Connaxio/espoir/README.md

espoir_iso1_1080

# Espoir
Espoir is a Power over Ethernet+ (PoE+ (802.3af/at)), mikroBUS<sup>TM</sup> mainboard based on the ESP32-MINI-1.

The full documentation for the project can be found on [Connaxio's Wiki](https://connaxio.github.io/espoir/hardware.html), including features and specifications and quick-start guides for tools like Arduino and MicroPython.
