Connaxio/espoir/doc/design_calcs.ods

Sheet: MP6004
 |  |  | MP6004 method
Vin_max | 57 | V | I_pk_max | 2.673E+00 | A |  | Dmax | 45.70%
Vin_min | 37 | V | Vout_1 | 5.03E+00 | V |  | Isec rms max | 5.99E+00
Vd_max | 0.81 | V | Ilim | 2.641E+00 | A | Note : unused
Vd_min | 0.15 | V | Vcc | 11.53E+00 | V
V_LX max | 150 | V | Ton | 3.43E-06 | s
Rdson | 0.8 | Ohms | Tcon | 4.07E-06 | s
 |  |  | Tdelay | 500.00E-09 | s
Transformer PA3855.002 |  |  | Fsw_max | 125.04E+03 | Hz
Np | 5.33 |  | Pout_max | 18.03E+00 | W | After diode
Ns | 1 |  | Pout available | 15.53E+00
Na | 2 |  | Iout_max | 3.09 | A | 3.3A measured
L_p | 48.0E-06 | H | Cin min | 22.62E-06 |  | 200e-3 V max. 802.3af
L_lk | 670.0E-09 | H | Vpp_out | 60.97E-03
K1 | 1000
 |  |  | Psn | 292.15E-03
Feedback |  |  | Vsn max | 93
R1 | 60.4E+03 |  | Rsn max | 29.60E+03
R2 | 12.4E+03 |  | Vsn real | 78.51E+00
I_limit |  |  | Csn min | 3.20E-09
R3 | 41.2E+03 |  | dVsn real | 991.96E-03
Ripple |  |  | d_Isn | -70.71E+06
 |  |  | Isn_max | 2.82853750907781
Cout | 470.0E-06
Snubber |  |  | D pri | 42.84%
Rsn | 21.1E+03 |  | Iprms | 997.98E-03
SN ripple max | 10.00% |  | Pfet cond | 796.77E-03
Csn (derated) | 30.0E-09 | F | Pfet sw | 659.11E-06
T_rise_I_out_meas | 40.00E-09 |  | Dsec | 50.91%
Csn min | 7.58050356555871E-09 |  | Isec_rms | 5.80E+00
 |  |  | Vreflected | 31.14E+00
 |  |  | Vrev_diode_min | 22.02E+00
Vin_rms_meas | 0.6 |  | I_diode_min | 7.54E+00
Pin_meas | 20 |  | Icout rms | 4.9090401735671
Iin_rms | 0.666666666666667 |  | Icout rms | 4.9621592352685
 |  |  | Icout rms
 |  |  | Icin_rms | 1.02665480685964
 |  |  | Icin_rms | 0.870946579711231

Sheet: si34061
Rclass | Value (Ohms) | I | Imin (1%) | Imax (1%)
R1 | 31.6 | 0.0174 | 0.0172 | 0.0197
R2 | 15.8 | 0.0287 | 0.0264 | 0.0296
R3 | 31.6 | 0.0430 | 0.0365 | 0.0434
R_ISNS
R | 0.36 | Ohms
I | 0.75 | Amps
P_R | 0.2025 | Watts
Rfreq
R | 100 | kOhms
Freq | 200 | kHz
DC-DC design | https://ro.mouser.com/pdfDocs/an1130-si3404-06x-dg.pdf
INPUTS |  |  | OUTPUTS
Transformer
Np | 6.67E+00 |  | Kr | 28.2227
Ns | 1.00E+00 |  | Fsw real | 7E+03
Na | 2.00E+00 |  | I_RDC | 0.0235
L_p | 80.00E-06 | H | delta_I | 1.3281
L_lk | 1.50E-06 | H | I_Fet_peak | 1.3281
K1 | 1.25E+03 |  | I_FET_RMS | 0.2716 | W
Ipeak | 2.16E+00 | A | P_leak | 0.2646 | V
Vin_min | 42.5 | V | Vout | 5.0000
Vin_max | 57 | V | Vf | 33.3500 | W
DC max | 50% |  | P_clamp_max | 0.3381 | Ohms
Pin | 0.5 | W | Rclamp_max | 36.51E+03
fsw | 200E+03 | Hz | C_Clamp_min | 2.74E-09
VDS_MAX (SWO) | 120 | V
Feedback (incomplete) | https://www.ti.com/lit/an/slua671/slua671.pdf?ts=1670448064802 |  |  |  |  | https://cbasso.pagesperso-orange.fr/Downloads/PPTs/Chris%20Basso%20APEC%20seminar%202010.pdf
Output ref voltage | 2.5 |  | RLED_max | 776.6497 | Ohms
R1 | 12400 |  | Gmid | 5.1000
R2 | 12400 |  | Rcomp2 | 12400.0000
Rpullup | 5100
Vf | 1
VDD | 5
VCE SAT | 0.25
RLED real | 1000
CTR | 1

Sheet: Crystal
Crystal load capacitance | 18 | pF
Trace capacitance | 3 | pF
MCU pin capacitance | 2 | pF
Load capacitor | 26

Sheet: RC snubber
Original oscillation frequency | 70.00E+06 | Hz
Added capacitor value | 1.00E-09 | F
New oscillation frequency | 36.70E+06 | Hz
Frequency shift ratio | 1.91E+00
Circuit parasitic capaticance | 379.07E-12
Circuit parasitic inductance | 13.64E-09
Base snubber cap value | 1.14E-09 | Close enough!
Final capacitor | 1.00E-09
Final resistor | 3.69E+00
Tested 3.33, 4.54, 5 Ohms. Best value is 5 Ohms
Source: | https://e2e.ti.com/blogs_/b/powerhouse/posts/calculate-an-r-c-snubber-in-seven-steps

Sheet: XFMR quick ref
PA3855.002
Np | 5.33E+00
Ns | 1.00E+00
Na | 2.00E+00
L_p | 48.00E-06
L_lk | 670.00E-09
K1 | 1.00E+03
Ipeak | 2.70E+00
PA3519
Np | 4.00E+00
Ns | 1.00E+00
Na | 2.00E+00
L_p | 73.50E-06
L_lk | 600.00E-09
K1 | 1.57E+03
Ipeak | 1.72E+00
PA1269
Np | 5.50E+00
Ns | 1.00E+00
Na | 3.75E+00
L_p | 77.40E-06
L_lk | 800.00E-09
K1 | 1.80E+03
Ipeak | 1.50E+00
PA3855.001
Np | 8.00E+00
Ns | 1.00E+00
Na | 3.00E+00
L_p | 54.00E-06
L_lk | 670.00E-09
K1 | 1.13E+03
Ipeak | 2.40E+00
PA5130.002
Np | 6.67E+00
Ns | 1.00E+00
Na | 2.00E+00
L_p | 80.00E-06
L_lk | 1.50E-06
K1 | 1.25E+03
Ipeak | 2.16E+00
