Connaxio/espoir/3d/Backplate/Espoir_backplate.FCStd

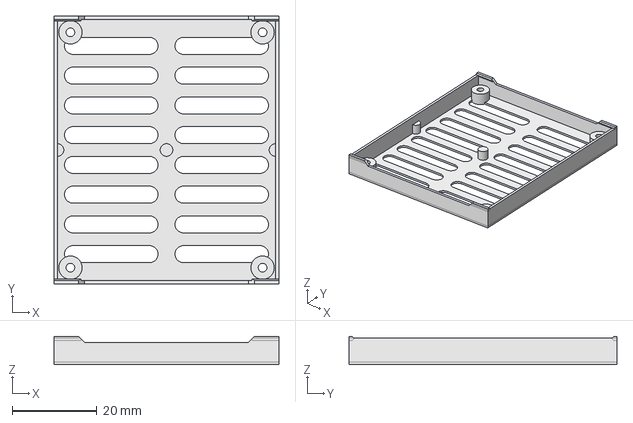
[picture p1: CAD file, 2022-06-09]
3d/Backplate/Espoir_backplate.FCStd
52.9 x 63.1 x 6.60 mm
