Connaxio/espoir/3d/rainproof_enclosure/rainproof_enclosure_2-Bottom.stl

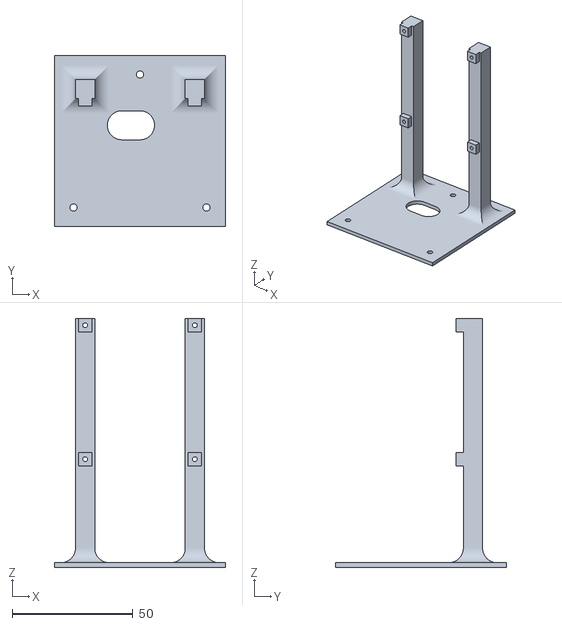
[picture p2: CAD file, 2022-10-03]
3d/rainproof_enclosure/rainproof_enclosure_2-Bottom.stl
70.8 x 70.8 x 103.0
