Connaxio/espoir/3d/rainproof_enclosure/rainproof_enclosure_2.FCStd

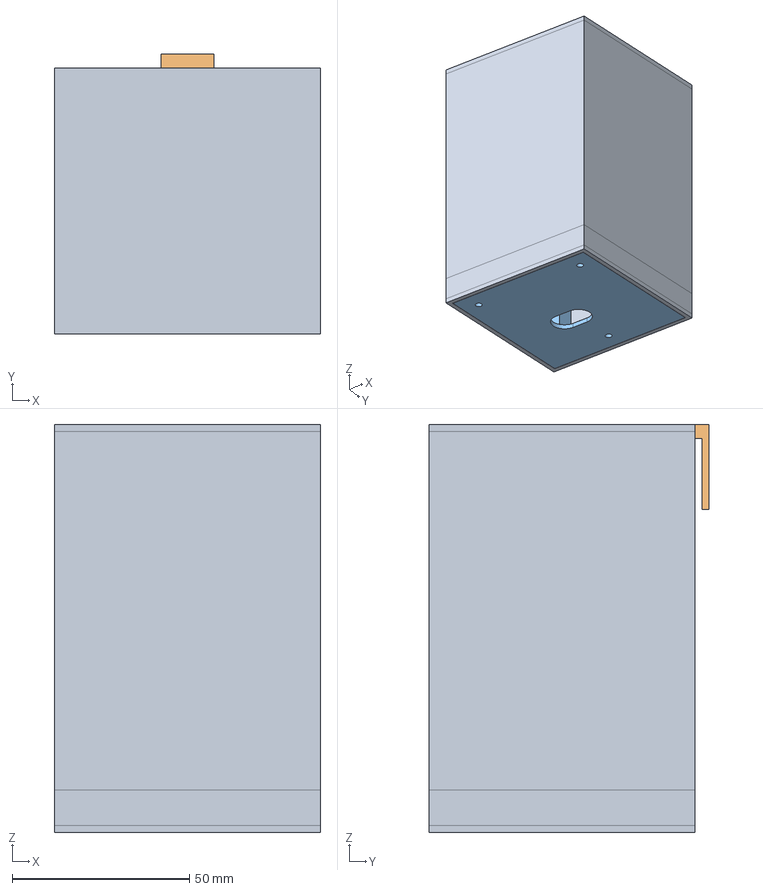
[picture p3: CAD file, 2022-10-03]
3d/rainproof_enclosure/rainproof_enclosure_2.FCStd
75.0 x 79.0 x 115.0 mm
