Connaxio/espoir/3d/rainproof_enclosure/rainproof_enclosure_2-Top.stl

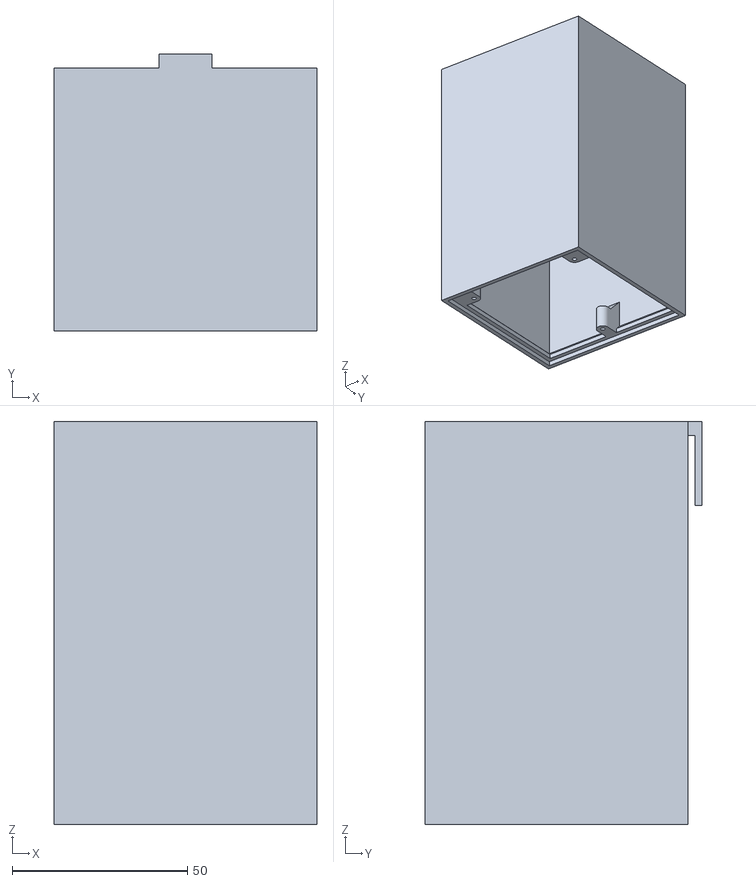
[picture p4: CAD file, 2022-10-03]
3d/rainproof_enclosure/rainproof_enclosure_2-Top.stl
75.0 x 79.0 x 115.0
