Connaxio/espoir/(list of files, cad)

Other CAD files:
3d/Backplate/Espoir_backplate.stl
