Connaxio/espoir/(commit log)

2022-05-02 Enlarge PCB for MikroE compatibility. Routing incomplete
    [design_calcs.ods, espoir.kicad_pcb, espoir.kicad_sch]
2022-05-04 Remove 12V output due to too poor cross regulation on stacked windings Replace 5.6V with 5V Change 100 mils headers to match mikroBUS Change dimensions to accomodate mikroBUS Place components on board
    [design_calcs.ods, espoir.kicad_pcb]
2022-05-05 Complete routing with new mikroBUS headers layout and DRC pass.
    [espoir.kicad_pcb, espoir.kicad_sch]
2022-05-06 Complete new mikroBUS layout (DRC passed). Add mikroBUS documentation
    [espoir.kicad_pcb, espoir.kicad_sch]
2022-05-07 Rename licence guide. Modify pinout.
    [espoir.kicad_pcb, espoir.kicad_sch]
2022-05-09 Add OSHW certification logo with UID.
    [espoir.kicad_pcb]
2022-05-12 Silkscreen fixes
    [espoir.kicad_pcb]
2022-05-13 Move extra IO header oustide mikroBUS zone re-fix silkscreen
    [espoir.kicad_pcb]
2022-05-18 Fix courtyard collisions
    [espoir.kicad_pcb]
2022-05-19 Add mikroBUS area delimitation line and move PoE Class connector further away
    [espoir.kicad_pcb]
2022-05-20 Fix PoE isolation keepout outline in lower-right corner.
    [espoir.kicad_pcb]
2022-05-29 Adjust flyback adjust resistor
    [design_calcs.ods, espoir.kicad_pcb, espoir.kicad_sch]
2022-05-31 Add Flyback RC snubber values
    [design_calcs.ods, espoir.kicad_sch]
2022-06-03 Update Datasheet Reduce 5V current loop size
    [espoir.kicad_pcb]
2022-06-09 Update datasheet Add Electrocution and burn hazard logos Add 3D printed snap-on backplate
    [Espoir_backplate.FCStd, Espoir_backplate.stl, espoir.kicad_pcb]
2022-06-18 Change license source location Fix holes to accomodate #4 screws
    [espoir.kicad_pcb]
2022-09-07 Replace solid connections with thermal reliefs where possible to improve soldering.
    [espoir.kicad_pcb]
2022-09-12 Fix: Solid plane connections now limited to Flyback transformer, output diode and IC
    [espoir.kicad_pcb]
2022-10-03 Add 3D complimentary designs: Backplate and rainproof enclosure
    [rainproof_enclosure_2-Bottom.stl, rainproof_enclosure_2-Top.stl, rainproof_enclosure_2.FCStd]
2022-10-04 Enlarge no-copper zone around ESP32 antenna
    [espoir.kicad_pcb]
2022-10-06 Improve Silkscreen
    [espoir.kicad_pcb]
2022-11-07 Change 5V setting resistor Add RoHS mention
    [espoir.kicad_pcb, espoir.kicad_sch]
2022-11-20 Change flyback output diode
    [espoir.kicad_pcb, espoir.kicad_sch]
2022-12-06 Calculations done for Si34061. Missing reference and RCD clamp parts.
    [design_calcs.ods, espoir.kicad_sch]
2022-12-19 Preliminary Si34061 design, DRC pass
    [design_calcs.ods, espoir.kicad_pcb, espoir.kicad_sch]
2023-02-14 Fix Reference bias resistor.
    [espoir.kicad_pcb, espoir.kicad_sch]
2023-02-14 Add source url to schematics.
    [espoir.kicad_pcb, espoir.kicad_sch]
2023-07-03 Move PoE class resistors to top layer
    [design_calcs.ods, espoir.kicad_pcb, espoir.kicad_sch]
2023-07-03 Switch to design with KSZ8091RND without crystal
    [espoir.kicad_pcb, espoir.kicad_sch]
2023-07-03 Update stackup to match JLC 3313
    [espoir.kicad_pcb]
