Connaxio/espoir/(notices)

Notices in the files:
pcb/espoir.kicad_pcb:
Licensed under
CERN-OHL-W v2
